dhakajack/ad9850vfo/README.md

# ad9850vfo
Bench signal generator based on ad9850 DDS and arduino

This is a self-contained "VFO-in-a-box", intended as a 
bench instrument, but can also pinch hit as an actual
VFO module, e.g., during radio construction.

The project is described in detail on my blog:

http://blog.templaro.com/vfo-in-a-box/
