dhakajack/ad9850vfo/vfoboxSchematicv1_0.png

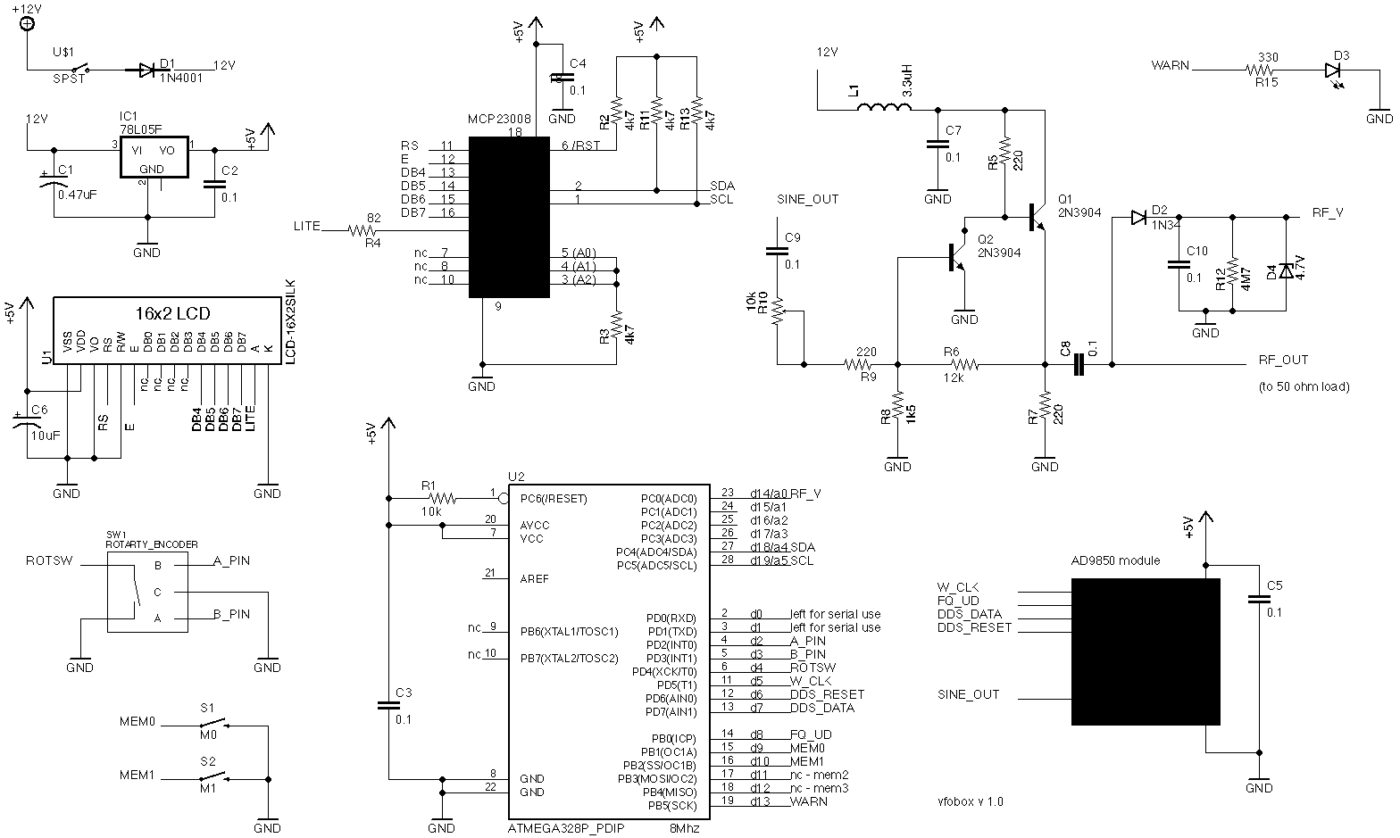
vfoboxSchematicv1_0.png
