dhakajack/ad9850vfo/vfobox.sch

## EAGLE design vfobox.sch (2017-08-10)

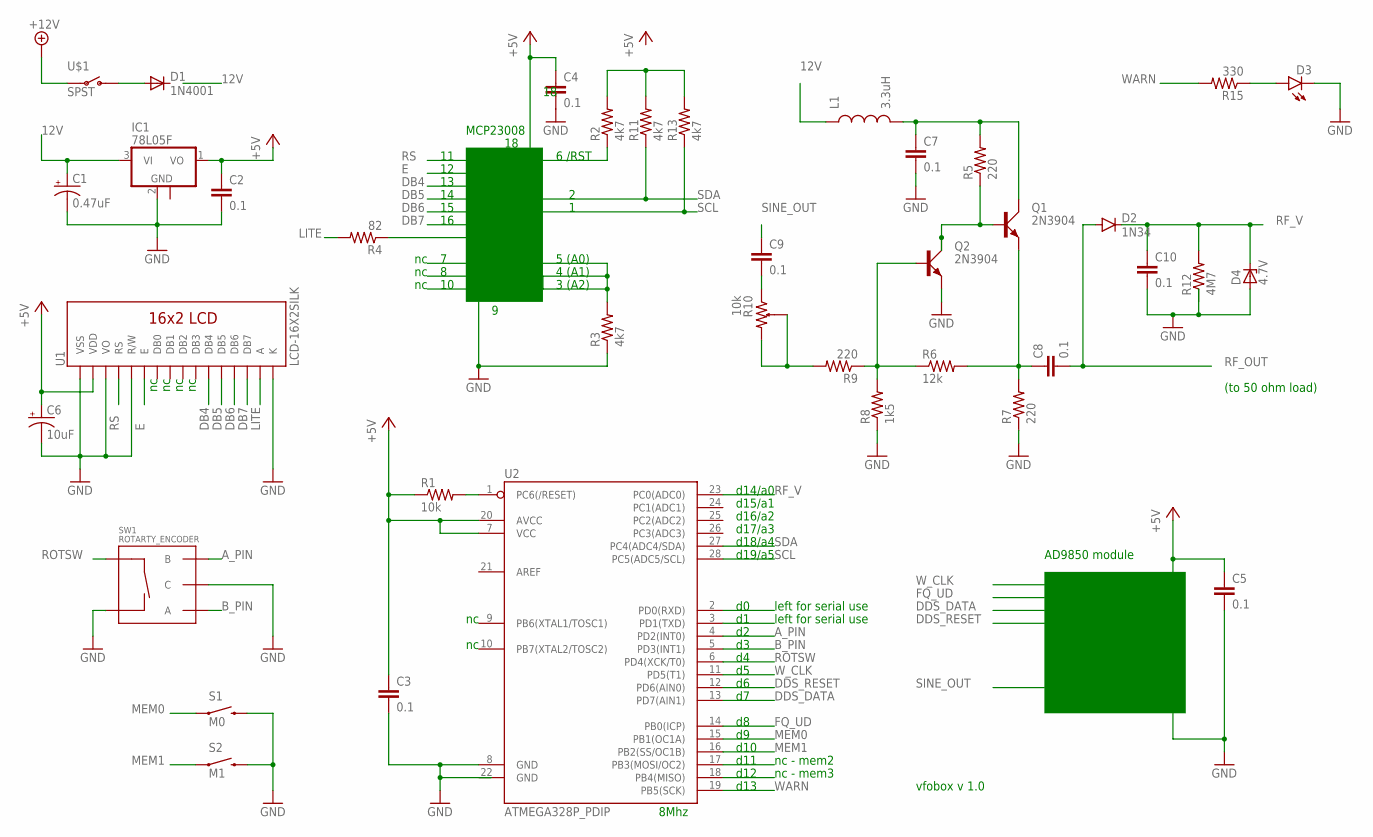
[picture p2: schematic vfobox.sch]

Parts:
C1: 0.47uF; EIA3216
C2, C3, C4, C5, C7, C8, C9, C10: 0.1; CAP-PTH-SMALL-KIT
C6: 10uF; EIA3216
D1: 1N4001; DO41-10
D2: 1N34; DIODE-1N4148
D3: LED5MM
D4: 4.7V; DO35Z10
IC1: 78L05F; SOT89
L1: 3.3uH; INDUCTOR-SRP4020
Q1, Q2: 2N3904; TO92D
R1: 10k; AXIAL-0.3-KIT
R2, R3, R11, R13: 4k7; AXIAL-0.3-KIT
R4: 82; AXIAL-0.3-KIT
R5, R7, R9: 220; AXIAL-0.3-KIT
R6: 12k; AXIAL-0.3-KIT
R8: 1k5; AXIAL-0.3-KIT
R10: 10k; 0603-ARV
R12: 4M7; AXIAL-0.3-KIT
R15: 330; AXIAL-0.3-KIT
S1: M0; TACTILE-PTH
S2: M1; TACTILE-PTH
SW1: ROTARTY_ENCODER; ROTARY_ENC_PLAIN
U1: LCD-16X2SILK; LCD-16X2
U2: ATMEGA328P_PDIP; DIL28-3
U$1: SPST; R_SW_TH

Connections:
12V: C1.A (+), IC1.3 (VI)
+5V: C2.1, C3.1, C4.1, C5.1, C6.A (+), IC1.1 (VO), R1.P$1 (1), U1.2 (VDD), U2.7 (VCC), U2.20 (AVCC)
+12V: U$1.P$4
A_PIN: SW1.B, U2.4 (PD2(INT0))
B_PIN: SW1.A, U2.5 (PD3(INT1))
DB4: U1.11 (DB4)
DB5: U1.12 (DB5)
DB6: U1.13 (DB6)
DB7: U1.14 (DB7)
DDS_DATA: U2.13 (PD7(AIN1))
DDS_RESET: U2.12 (PD6(AIN0))
E: U1.6 (E)
FQ_UD: U2.14 (PB0(ICP))
GND: C1.C (-), C2.2, C3.2, C4.2, C5.2, C6.C (-), C7.2, C10.2, D3.K (C), D4.A, IC1.2 (GND), Q2.E, R3.P$1 (1), R7.P$1 (1), R8.P$1 (1), S1.3 (2), S2.3 (2), SW1.C, SW1.SW-, U1.1 (VSS), U1.3 (VO), U1.5 (R/W), U1.16 (K), U2.8 (GND)
LITE: R4.P$2 (2), U1.15 (A)
MEM0: S1.1, U2.15 (PB1(OC1A))
MEM1: S2.1, U2.16 (PB2(SS/OC1B))
MEM2: U2.18 (PB4(MISO))
unnamed: R1.P$2 (2), U2.1 (PC6(/RESET))
unnamed: R9.P$2 (2), R10.2, R10.3
unnamed: C7.1, L1.P$2 (2), Q1.C, R5.P$2 (2)
unnamed: Q1.B, Q2.C, R5.P$1 (1)
unnamed: Q2.B, R6.P$1 (1), R8.P$2 (2), R9.P$1 (1)
unnamed: C8.1, Q1.E, R6.P$2 (2), R7.P$2 (2)
unnamed: C9.2, R10.1
unnamed: D1.A, U$1.P$3 (O)
unnamed: D3.A, R15.P$1 (1)
unnamed: R2.P$2 (2), R11.P$2 (2), R13.P$2 (2)
RESET: R2.P$1 (1)
RF_OUT: C8.2, D2.A
RF_V: C10.1, D2.C, D4.C, R12.P$2 (2), U2.23 (PC0(ADC0))
ROTSW: SW1.SW+, U2.6 (PD4(XCK/T0))
RS: U1.4 (RS)
SCL: R13.P$1 (1), U2.28 (PC5(ADC5/SCL))
SDA: R11.P$1 (1), U2.27 (PC4(ADC4/SDA))
SINE_OUT: C9.1
WARN: R15.P$2 (2), U2.19 (PB5(SCK))
W_CLK: U2.11 (PD5(T1))

Notes on the sheet:
AD9850 module
MCP23008
d10
d11
d12
d13
d14/a0
d15/a1
d16/a2
d18/a4
d19/a5
5 (A0)
4 (A1)
3 (A2)
6 /RST
8Mhz
left for serial use
(to 50 ohm load)
vfobox v 1.0
nc - mem2
nc - mem3
d17/a3
