dhakajack/ad9850vfo/(commit log)

2017-07-31 array of memory buttons
2017-07-31 mem buttons start with #1
2017-08-02 better name for encoder spin direction
2017-08-02 refactor rotary encoder check
2017-08-02 revise circuit description
2017-08-02 PNG of eagle schematic
2017-08-09 update schematic to reflect sketch
    [vfobox.sch]
2017-08-10 revised schematic
    [vfobox.sch]
